Taburn/XInC2-Dev2/Releases/XInC2 Dev - v2.0.0 20210410/Render/XInC2 Dev v2.0 - 09 Top Ortho White.png

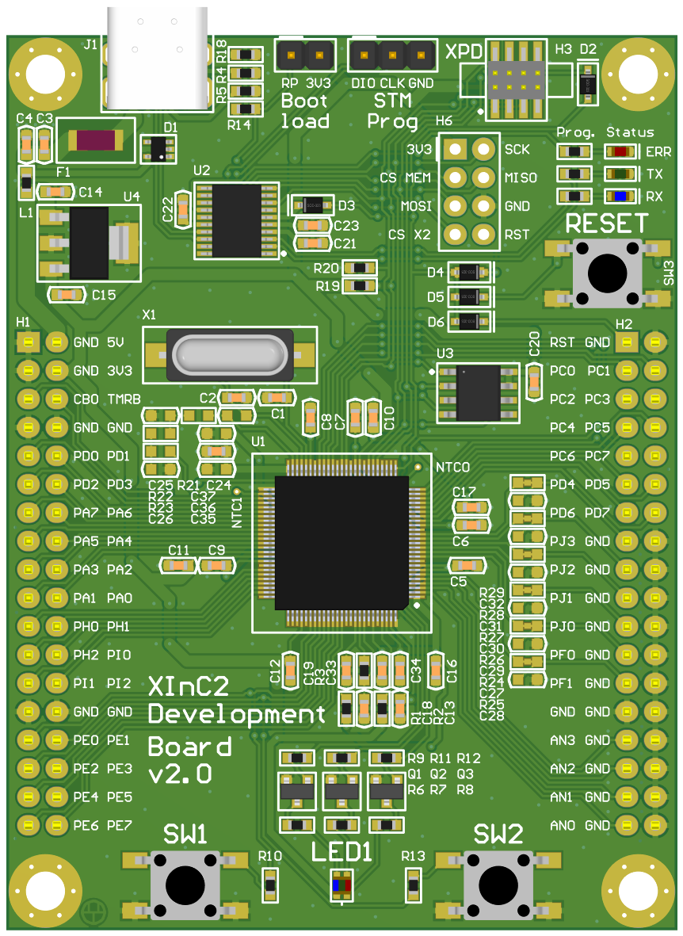
Releases/XInC2 Dev - v2.0.0 20210410/Render/XInC2 Dev v2.0 - 09 Top Ortho White.png
