Taburn/XInC2-Dev2/Fuse/I2t analysis.odt

One of the parameters for a fuse is I²t, which is a measure of the power the fuse can absorb before it melts and breaks the circuit.

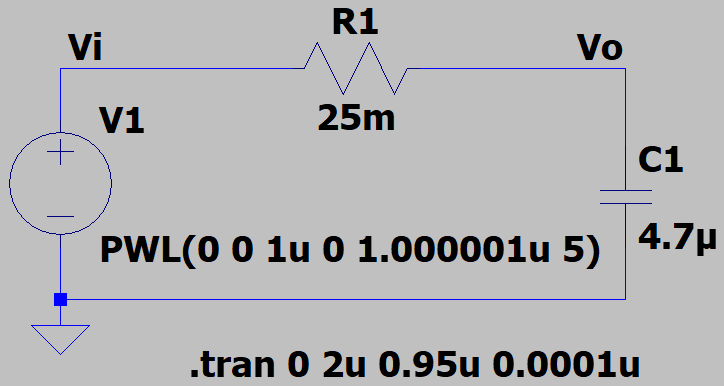
[picture p5: figure]

From basic circuit courses[^1] we know that, if V1 is suddenly turned on, the voltage across the capacitor will be:

V_o = V_{i} (1-e^(-t/RC))

Therefore, the current through the resistor will be:

I_R = {V_i - V_o} over {R}

I_R = {V_i - V_{i} (1-e^(-t/RC) )} over {R}

I_R = {V_i} over {R} ({1 - (1-e^(-t/RC) )})

I_R = {V_i} over {R} ({1 - 1+e^(-t/RC) })

underline {I_R = {V_i} over {R} e^(-t/RC)}

If the resistor is a fuse, we can find an expression for it’s I²t value:

I^2 t = int from{0} to{∞} I_R^2 dt

int from{0} to{∞} ({{V_i} over {R} e^(-t/RC)})^2 dt

( {V_i} over {R} )^2 int from{0} to{∞} e^(-2t/RC) dt

( {V_i} over {R} )^2 {RC} over {2}

underline { I2T = {V_i^2 C} over {2R}}

So, for a theoretical case where Vi = 5V, C = 4.7uF and R = 25mΩ: I²t = 2.35E-3

Let’s validate this by running the above simulation in LTspice:

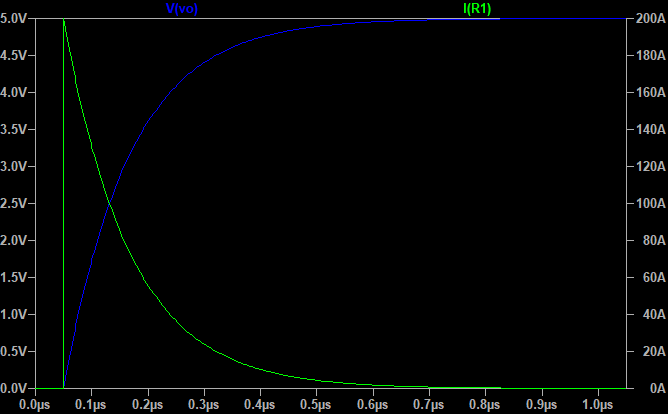
[picture p6: figure]

The csv data for I(R1) was exported. It’s value was squared, then imported into Graph:

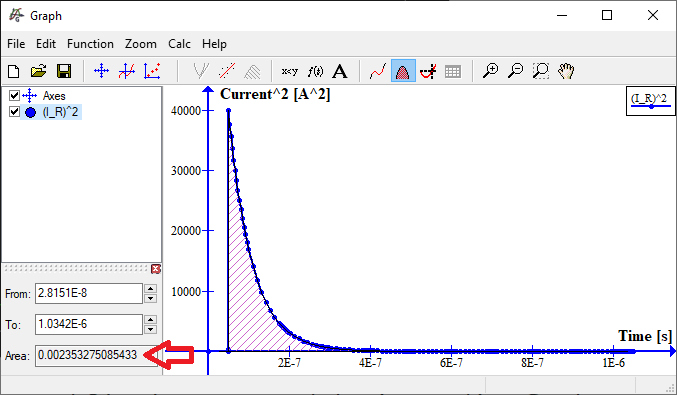
[picture p7: figure]

Graph calculated the integral as 2.3533E-3, which agrees with the theoretical value.

[^1] spinningnumbers.org/a/rc-step-response.html
