Taburn/XInC2-Dev2/Perf Spec/XInC2 Dev 2 Perf Spec Public 20210115.pdf

## XInC2 Dev 2 Perf Spec

Adam Gulyas
January 15, 2021

- The target audiences are university capstone groups and hobbyists.
- Design choices will heavily weight compatibility with Arduino and Raspberry Pi ecosystems.
- If possible, PCB design will be two layer, single sided.
- PCB will be able to populate either EEPROM or Flash memory ICs through the use of common footprints and pin outs. Compatible part numbers for each type will be identified.

XInC2 Dev 2
General Info
2021-01-07

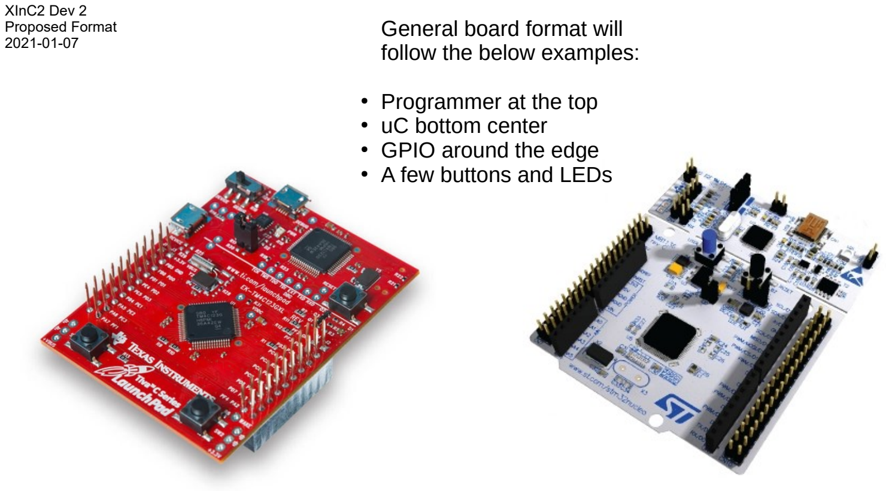
[picture p8: page 3]

Proposed Format
2021-01-07

General board format will
follow the below examples:
- Programmer at the top ● uC bottom center ● GPIO around the edge ● A few buttons and LEDs

Block Diagram
Rough PCB Layout
2021-01-07

No crystal pulling. Let
the user use TMRB for
something else.

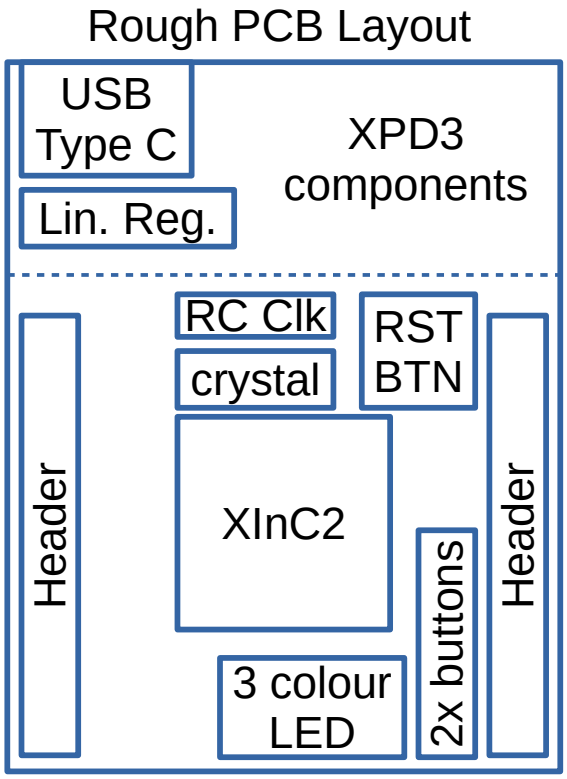
[picture p9: figure]
XPD3 components; XInC2; USB Type C; crystal; Lin. Reg.; 3 colour LED; RST BTN; RC Clk; er Rough PCB Layout
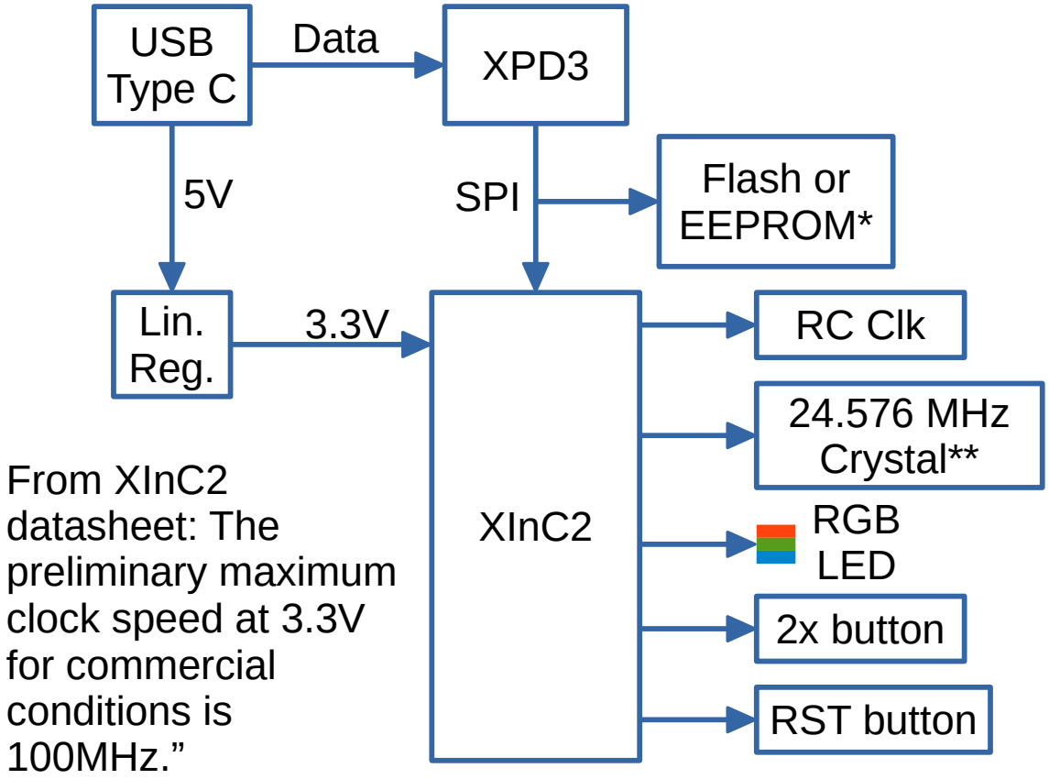
[picture p10: figure]
USB Type C; Lin. Reg.; XInC2; XPD3; RGB LED; SPI; 2x button; RST button; Data; 24.576 MHz Crystal**; RC Clk; From XInC2 datasheet: The preliminary maximum clock speed at 3.3V for commercial conditions is 100MHz.”; Flash or EEPROM*

* Either population option possible ** Use a common crystal footprint to enable using other frequencies
