Taburn/XInC2-Dev2/Releases/XInC2 Dev - v2.0.0 20210410/Placement/XInC2 Dev - Placement v2.0 20210410.pdf

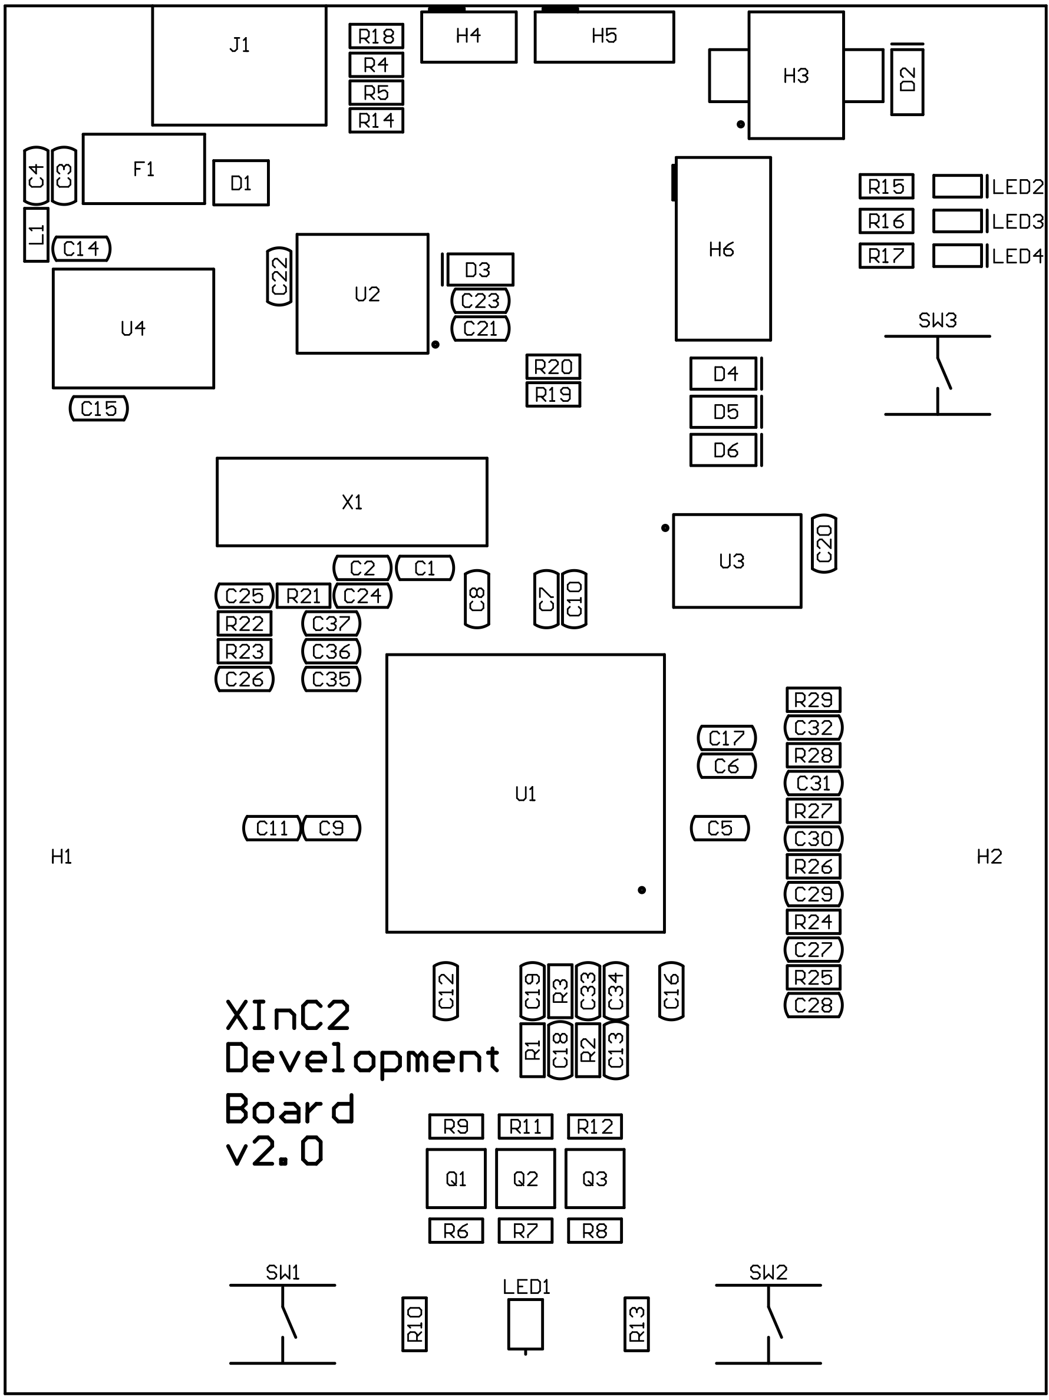
[picture p11: page 1]
