Taburn/XInC2-Dev2/Reference/Bolt Hole Footprint Dimensions.png

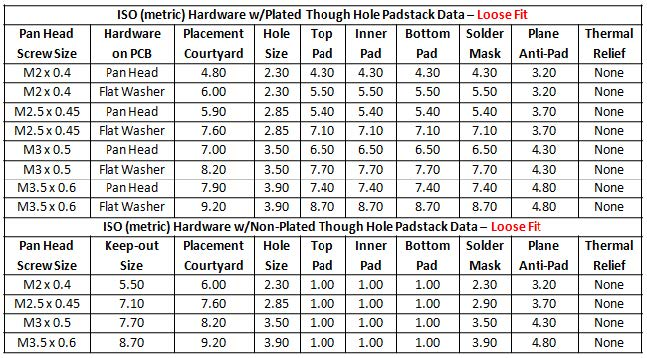
Reference/Bolt Hole Footprint Dimensions.png
