Taburn/XInC2-Dev2/Reference/USB Type C to Type A connection.png

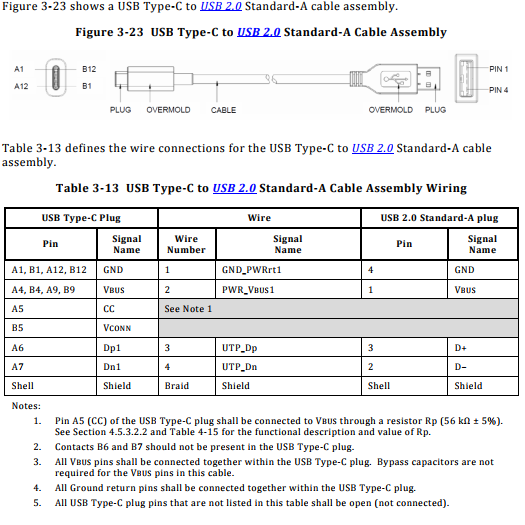
Reference/USB Type C to Type A connection.png
