Taburn/XInC2-Dev2/Releases/LED Board - v1.0.0 20210410/Placement/LED Board - Placement v1.0 20210410.png

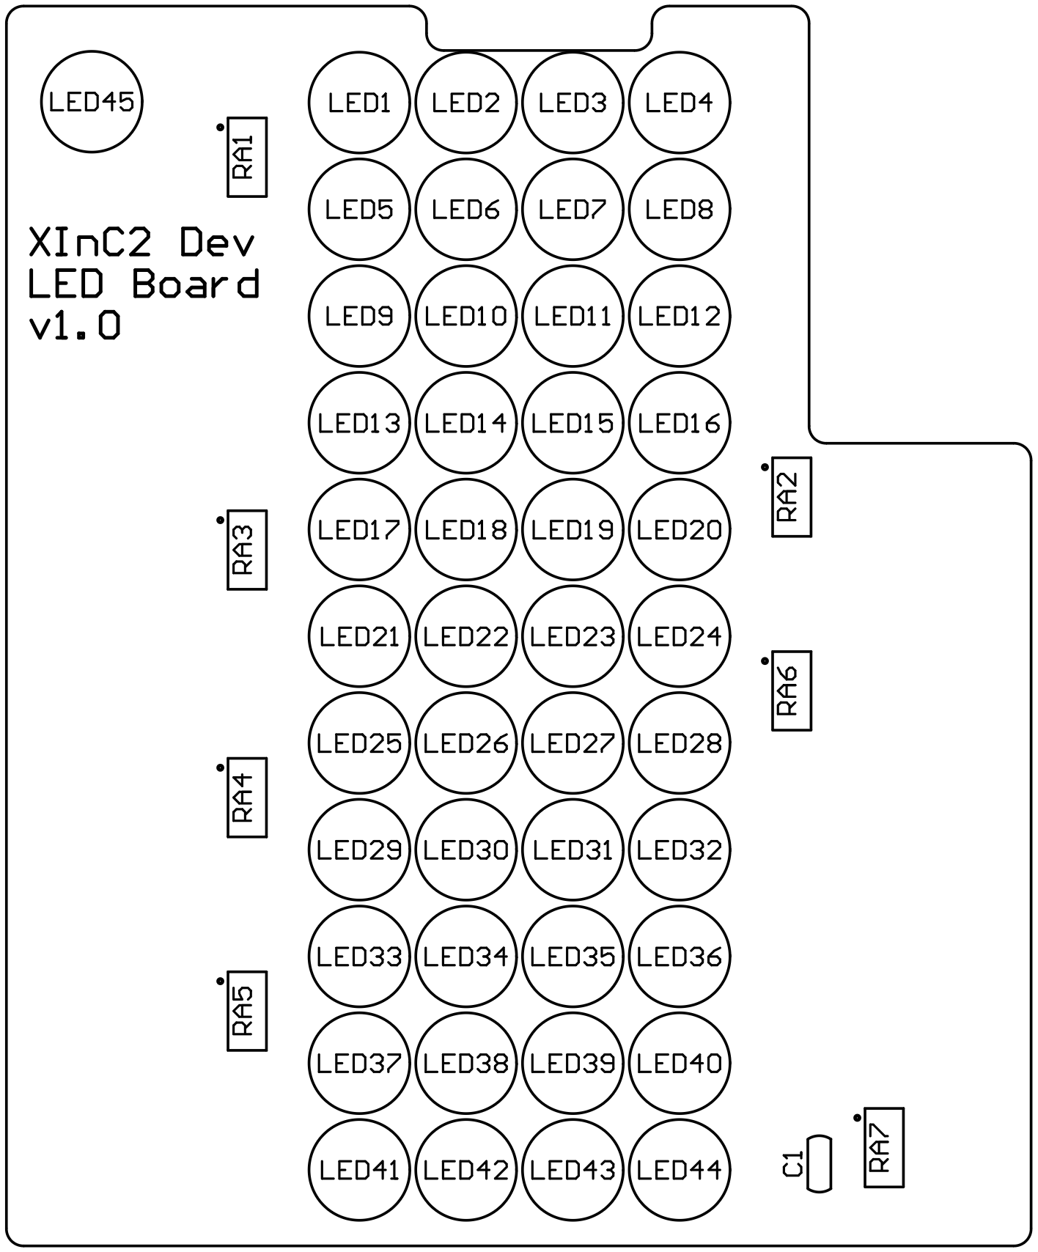
Releases/LED Board - v1.0.0 20210410/Placement/LED Board - Placement v1.0 20210410.png
