Taburn/XInC2-Dev2/Releases/LED Board - v1.0.0 20210410/Render/LED Board - 3 Top ISO.png

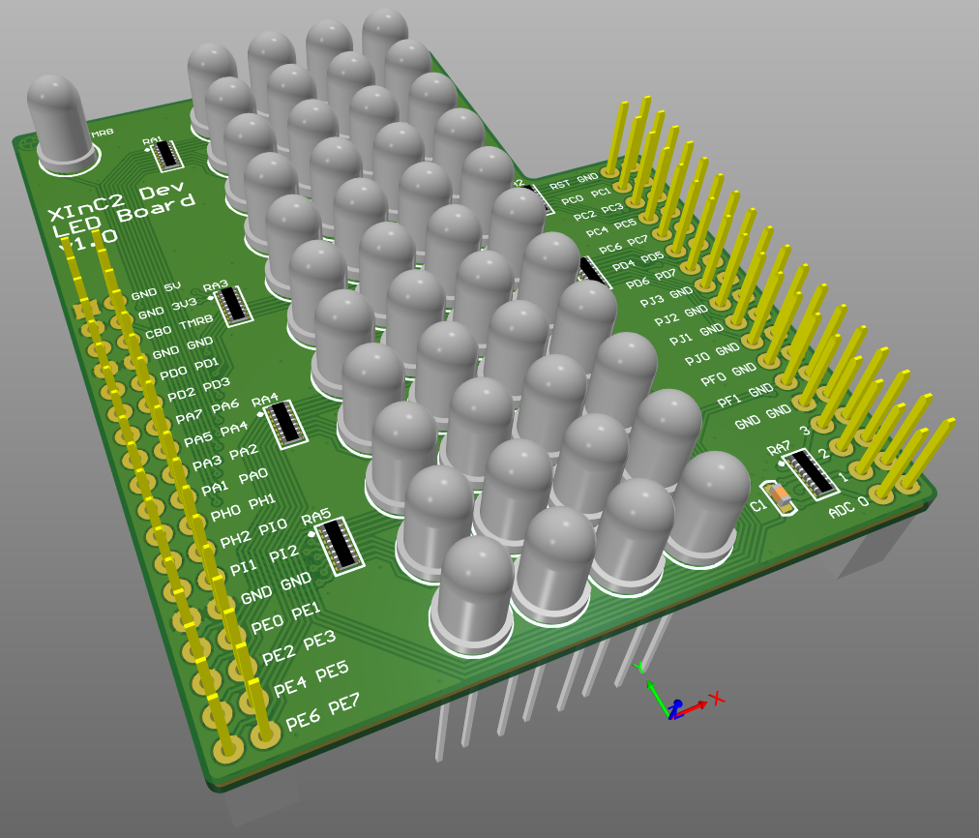
Releases/LED Board - v1.0.0 20210410/Render/LED Board - 3 Top ISO.png
