Taburn/XInC2-Dev2/Releases/LED Board - v1.0.0 20210410/Render/LED Board - 4 Top Layer.png

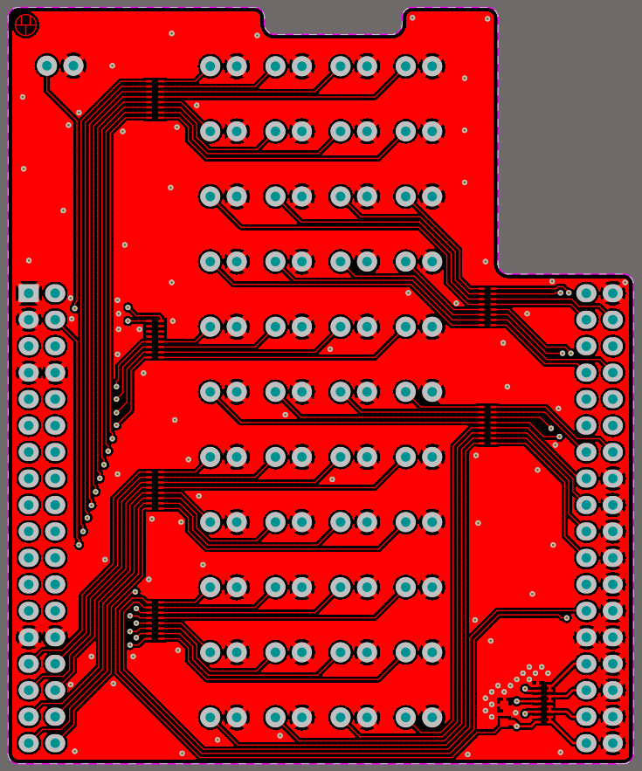
Releases/LED Board - v1.0.0 20210410/Render/LED Board - 4 Top Layer.png
