Taburn/XInC2-Dev2/LED Shield/LED Shield - STEP.step

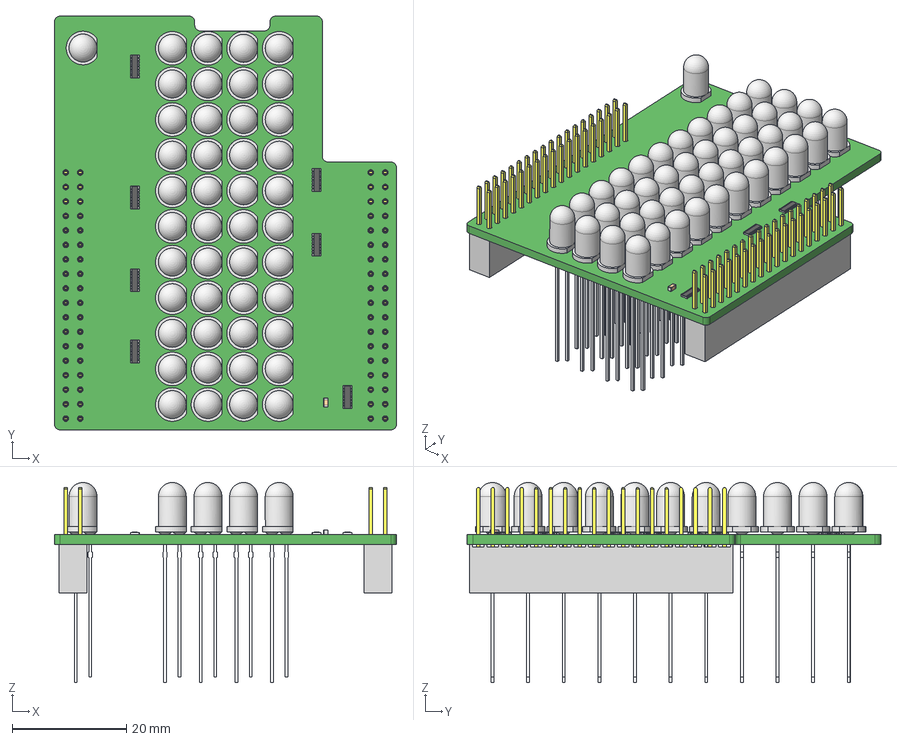
[picture p30: CAD file, 2021-04-11]
LED Shield/LED Shield - STEP.step
60.0 x 72.6 x 35.1 mm
Board
ceramic_cap_0603
_T1SSQ-118-03-T-D x 2
_P2SSQ-118-03-T-D x 2
YC248 x 7
Wurth_-_151051BS04000_-_TH_LED x 45
