Taburn/XInC2-Dev2/Releases/XInC2 Dev - v2.0.0 20210410/Mechanical/XInC2 Dev - Holes v2.0 20210410.dxf

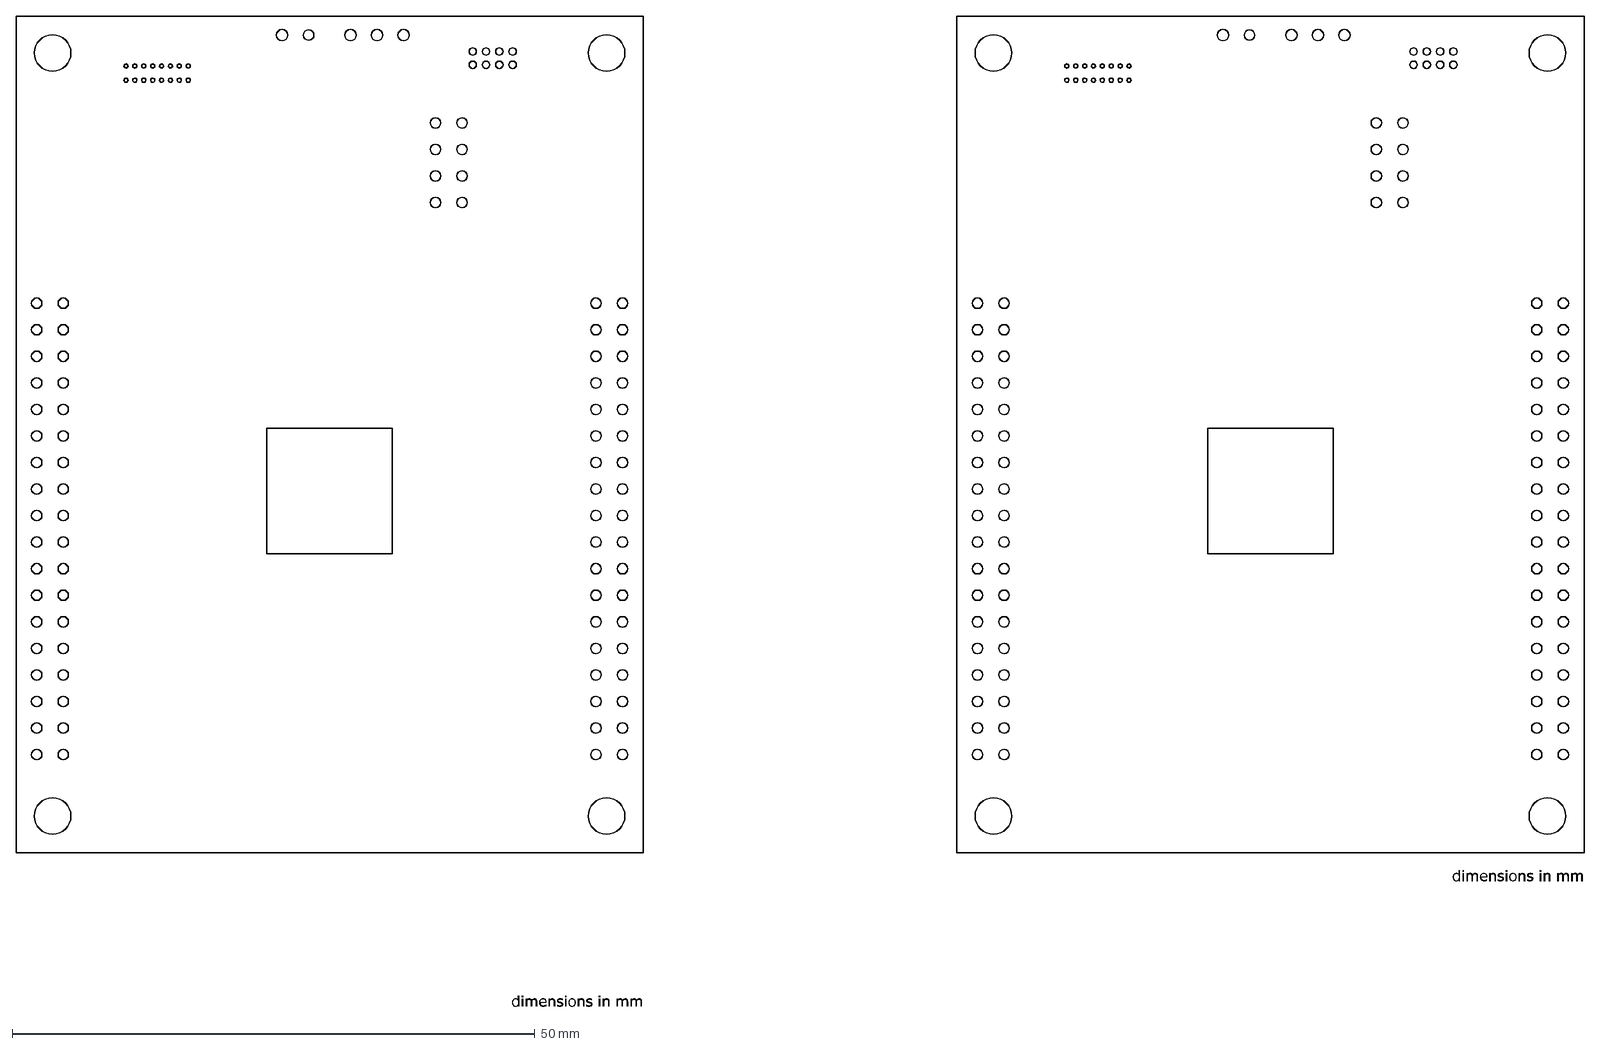
[picture p31: CAD file, 2021-04-11]
Releases/XInC2 Dev - v2.0.0 20210410/Mechanical/XInC2 Dev - Holes v2.0 20210410.dxf
dimensions in mm
