Taburn/XInC2-Dev2/Step Files/USB4085-GF-A.stp

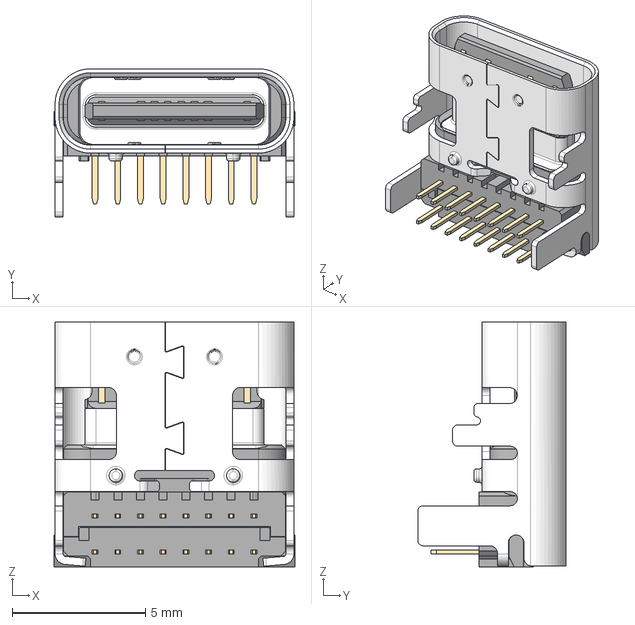
[picture p32: CAD file, 2021-04-11]
Step Files/USB4085-GF-A.stp
9.03 x 5.56 x 9.17 mm
ÇÐ³ý-ÀÉì1
Í¹Ì¨-ÀÉì1
