Taburn/XInC2-Dev2/Step Files/SSQ-118-03-T-D.stp

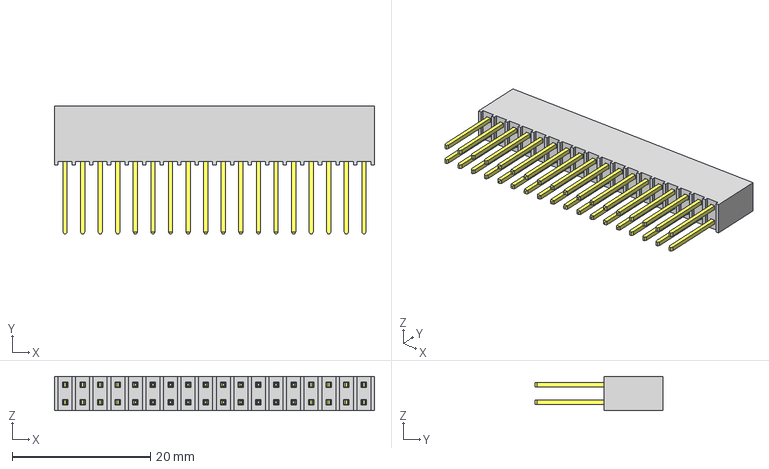
[picture p33: CAD file, 2021-04-11]
Step Files/SSQ-118-03-T-D.stp
46.2 x 18.5 x 4.95 mm
_T1SSQ-118-03-T-D
_P2SSQ-118-03-T-D
