Taburn/XInC2-Dev2/Step Files/SOIC 8.step

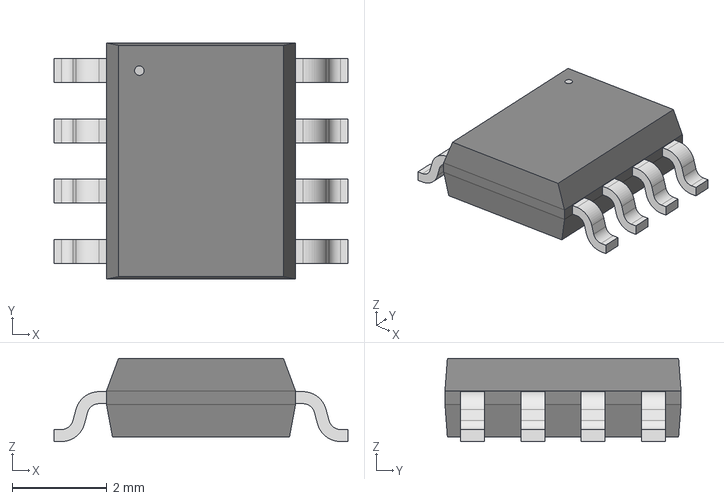
[picture p34: CAD file, 2021-02-04]
Step Files/SOIC 8.step
6.20 x 4.98 x 1.75 mm
