Taburn/XInC2-Dev2/Step Files/TQFP100 0_4mm.step

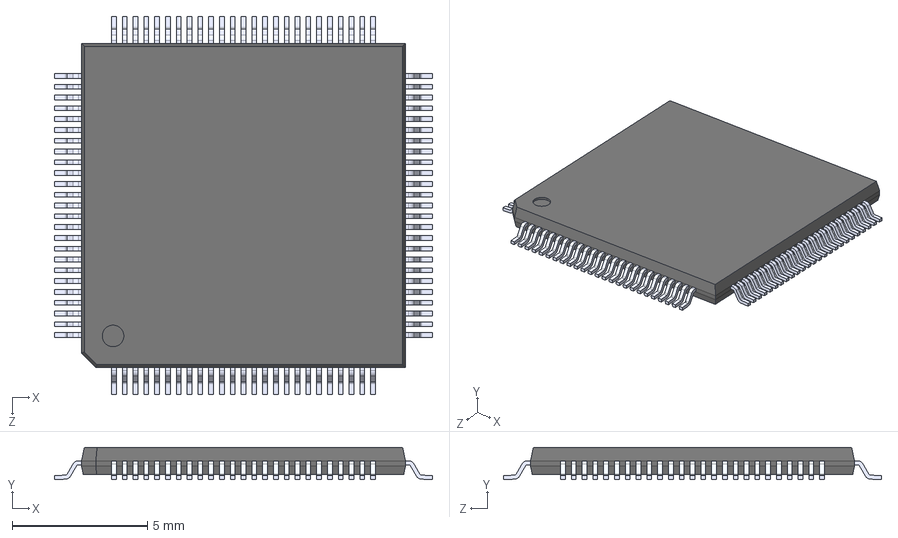
[picture p35: CAD file, 2021-02-04]
Step Files/TQFP100 0_4mm.step
14.0 x 1.20 x 14.0 mm
