Taburn/XInC2-Dev2/Step Files/FFSD-04-S-01.00-01.stp

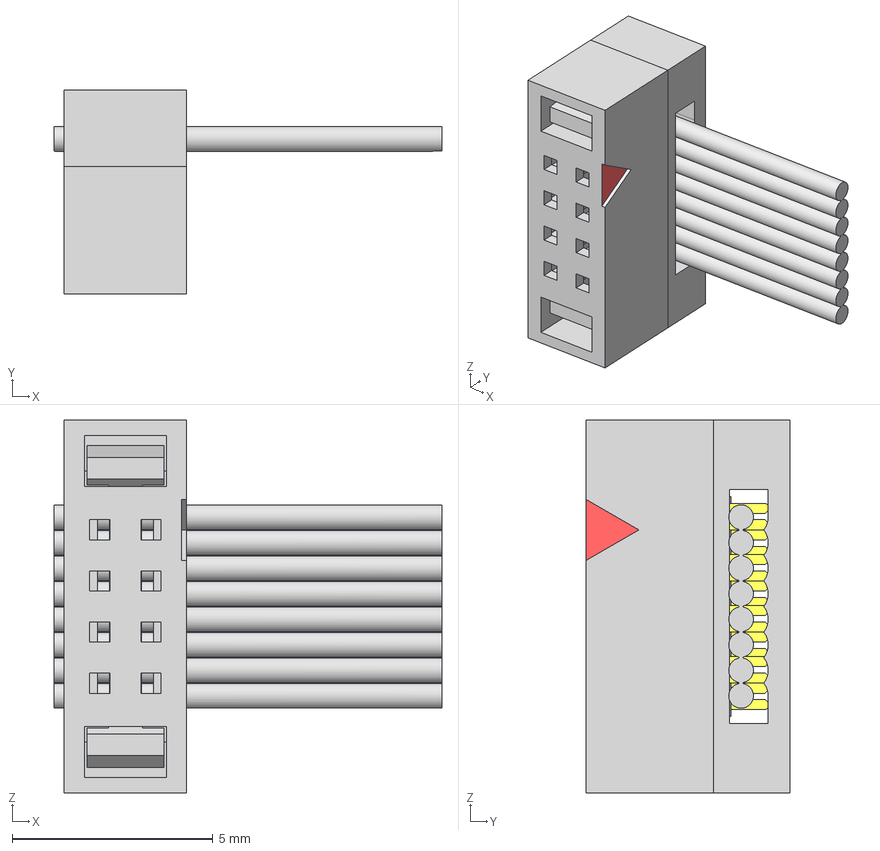
[picture p36: CAD file, 2021-02-04]
Step Files/FFSD-04-S-01.00-01.stp
9.65 x 5.08 x 9.27 mm
_FFSD-040LB
_FFSD-04()ub
_FFSD-04pin x 2
