Taburn/XInC2-Dev2/Step Files/FTS-104-01-L-DV.stp

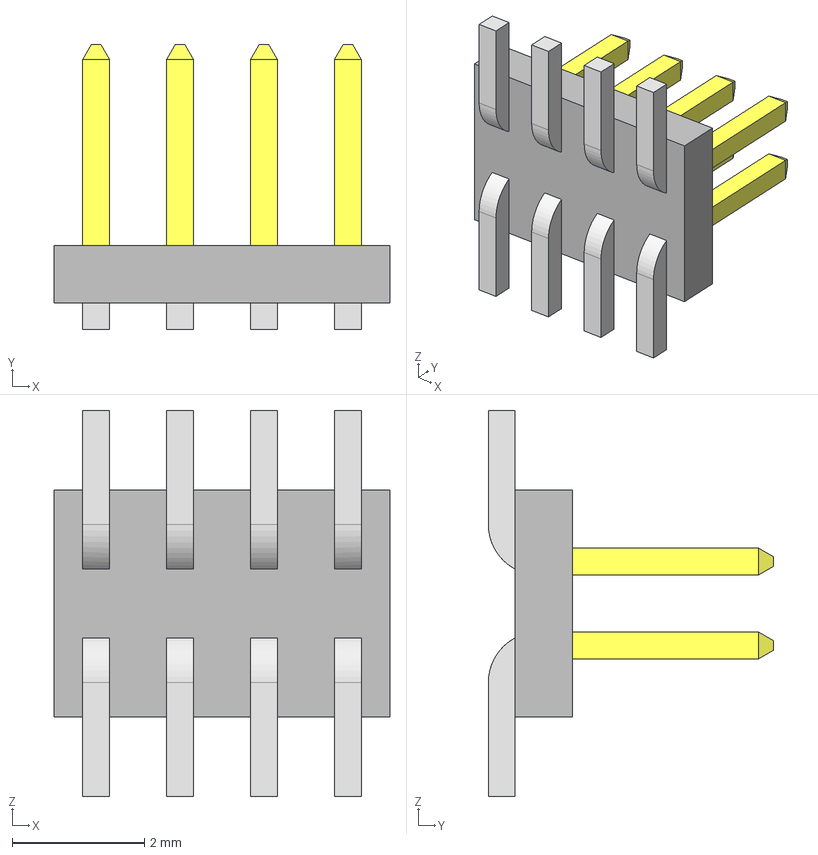
[picture p37: CAD file, 2021-02-04]
Step Files/FTS-104-01-L-DV.stp
5.08 x 4.32 x 5.84 mm
_FTS-104-01-L-DV_body
_FTS-104-01-L-DV_pins1
_FTS-104-01-L-DV_pins2
