Taburn/XInC2-Dev2/Step Files/YC248.step

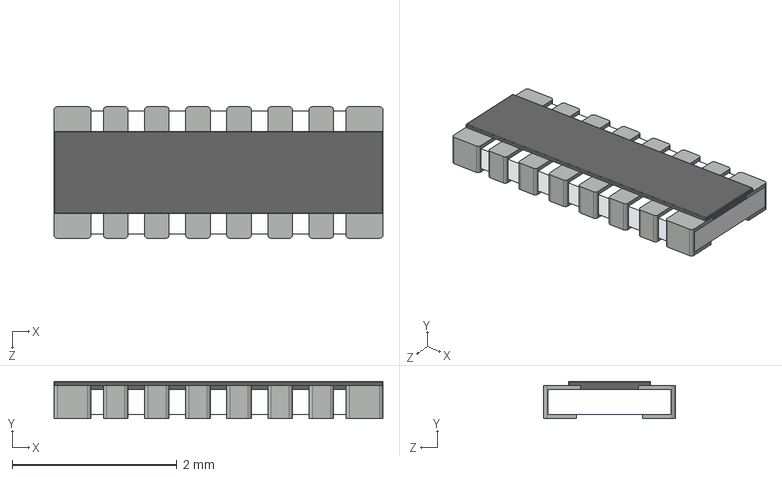
[picture p38: CAD file, 2021-01-30]
Step Files/YC248.step
4.00 x 0.45 x 1.60 mm
