Taburn/XInC2-Dev2/Step Files/Wurth - 151051BS04000 - TH LED.stp

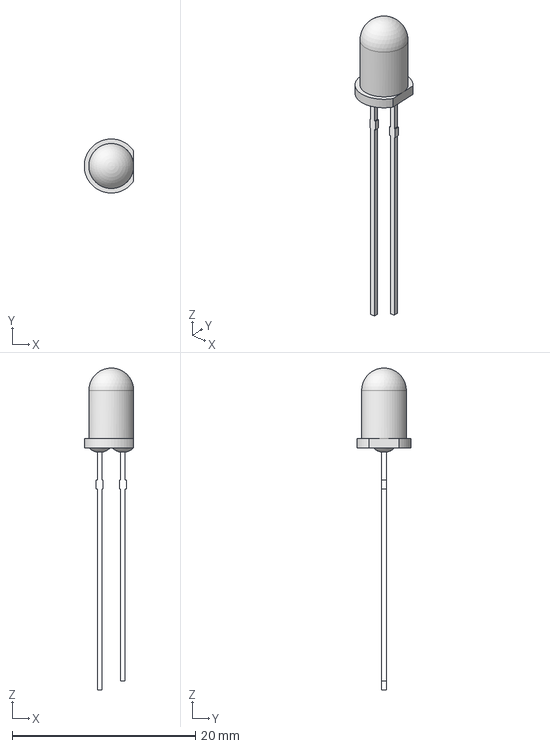
[picture p39: CAD file, 2021-01-30]
Step Files/Wurth - 151051BS04000 - TH LED.stp
5.39 x 5.90 x 35.1 mm
