Taburn/XInC2-Dev2/Step Files/SOT 223.step

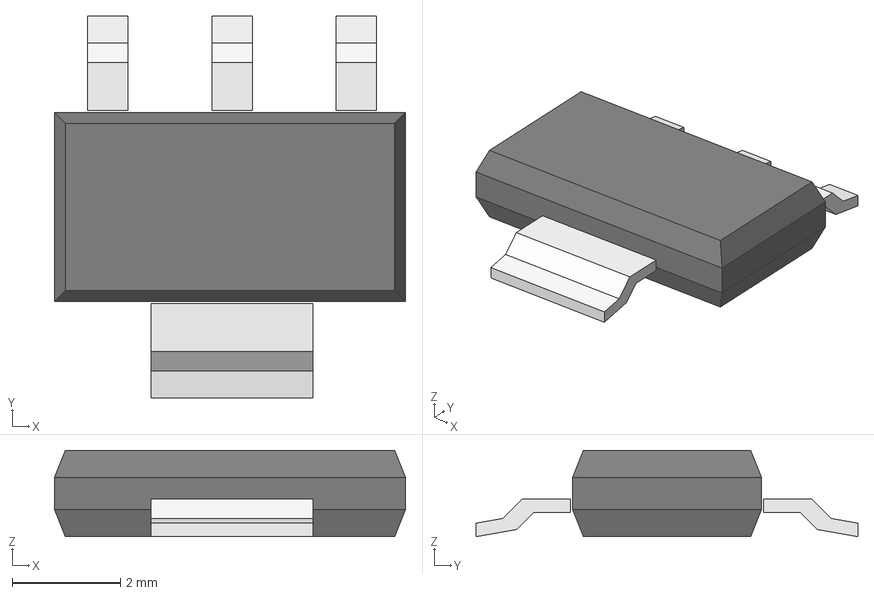
[picture p40: CAD file, 2021-01-26]
Step Files/SOT 223.step
6.50 x 7.07 x 1.60 mm
