Taburn/XInC2-Dev2/Step Files/SW - tact - SMT - HP0315AFKP2.stp

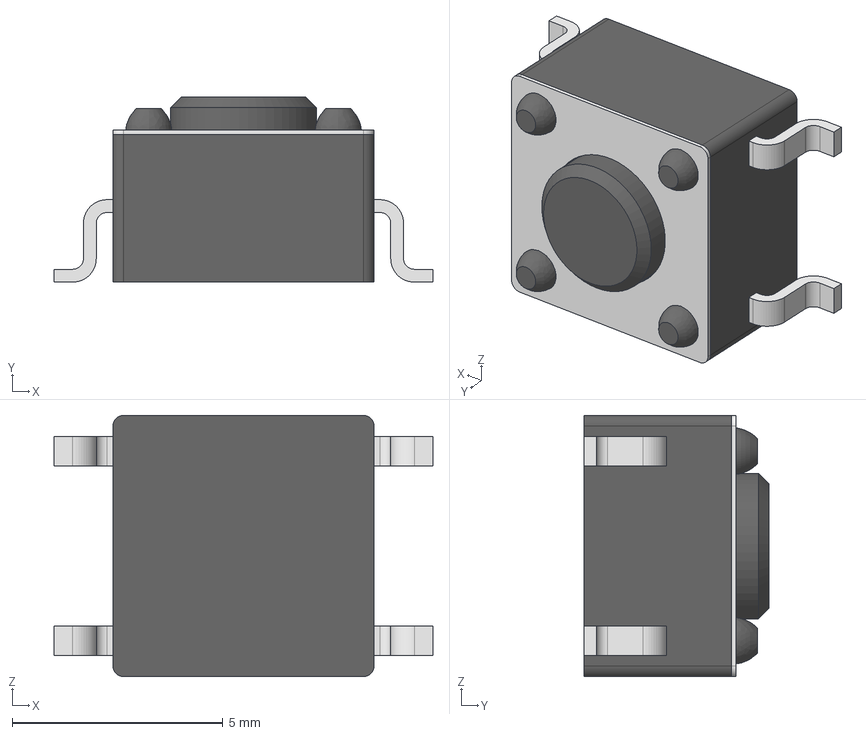
[picture p41: CAD file, 2021-01-26]
Step Files/SW - tact - SMT - HP0315AFKP2.stp
8.99 x 4.39 x 6.20 mm
_hp03-body
_hp03-cap
_hp03-button
_hp03-pinn-P2 x 4
