Taburn/XInC2-Dev2/Step Files/TSSOP 20.stp

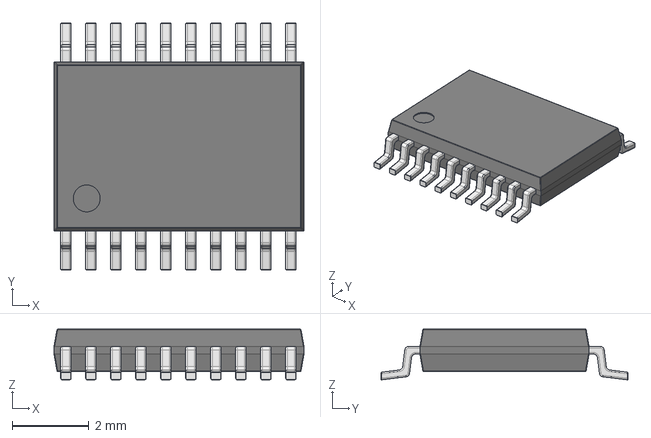
[picture p42: CAD file, 2021-01-26]
Step Files/TSSOP 20.stp
6.50 x 6.42 x 1.32 mm
扻豵鵨 TSSOP-20
Êîíòàêò x 20
