Taburn/XInC2-Dev2/Step Files/SOD 323.STEP

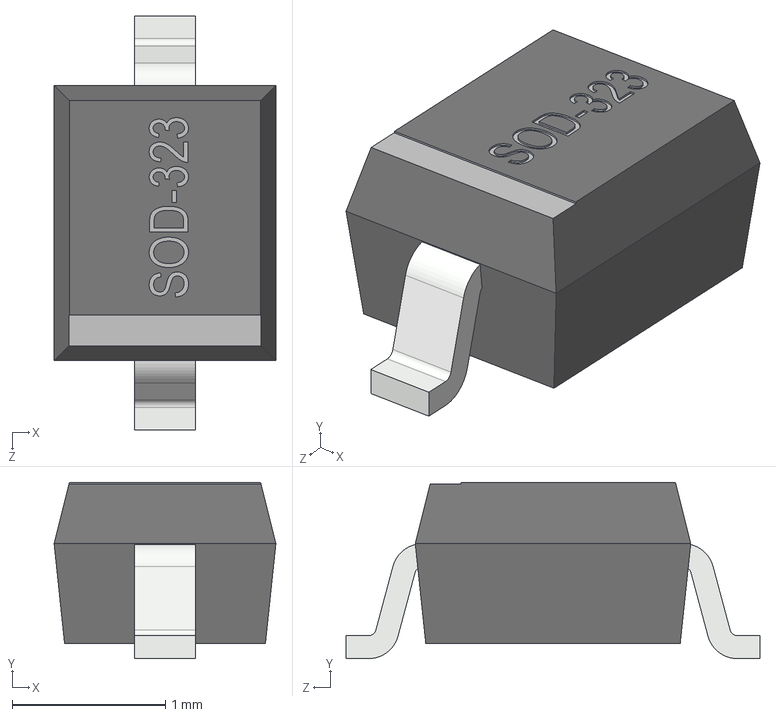
[picture p43: CAD file, 2021-01-26]
Step Files/SOD 323.STEP
1.45 x 1.15 x 2.70 mm
