Taburn/XInC2-Dev2/Step Files/USB4110-GF-A.stp

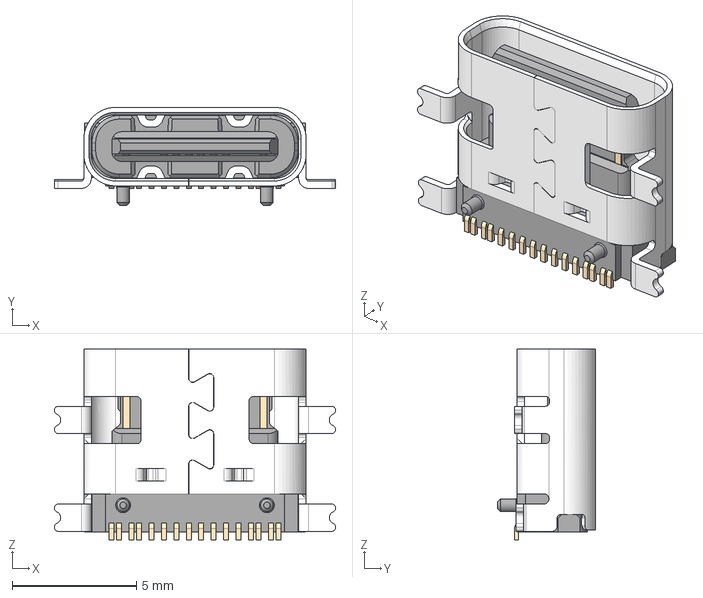
[picture p44: CAD file, 2021-01-26]
Step Files/USB4110-GF-A.stp
11.3 x 3.96 x 7.68 mm
