Taburn/XInC2-Dev2/Step Files/HC49 US.STEP

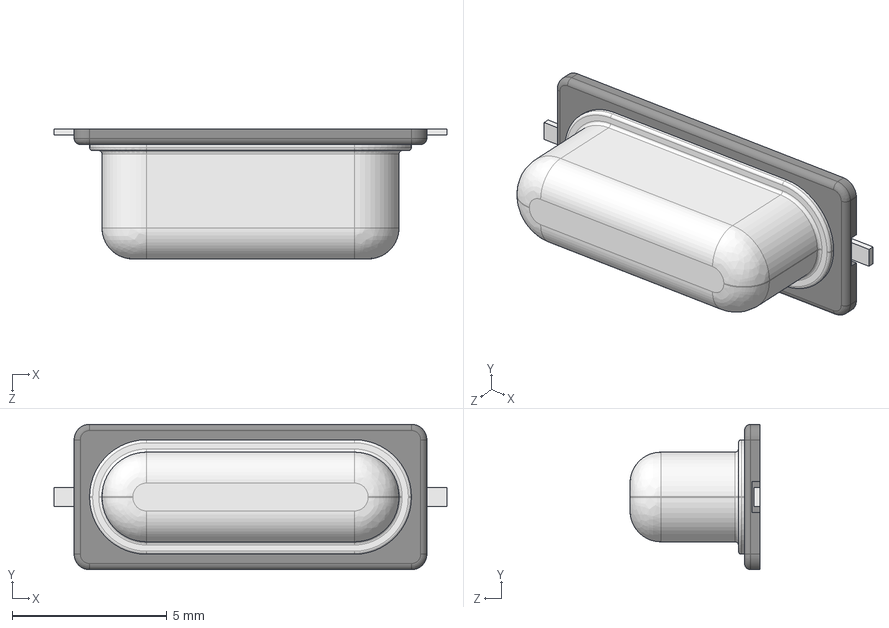
[picture p45: CAD file, 2021-01-26]
Step Files/HC49 US.STEP
12.7 x 4.70 x 4.20 mm
