Taburn/XInC2-Dev2/Step Files/C 0603.stp

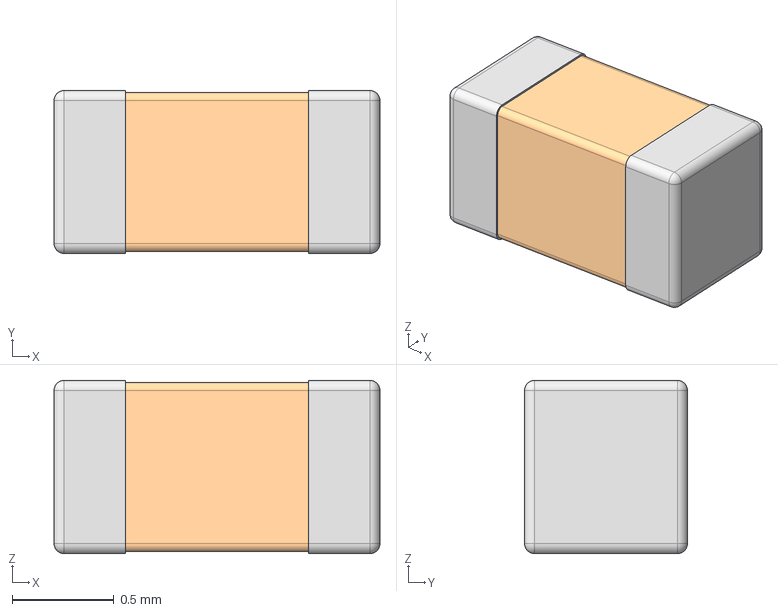
[picture p46: CAD file, 2021-01-26]
Step Files/C 0603.stp
1.60 x 0.8 x 0.85 mm
