Taburn/XInC2-Dev2/Step Files/SOT 353.STEP

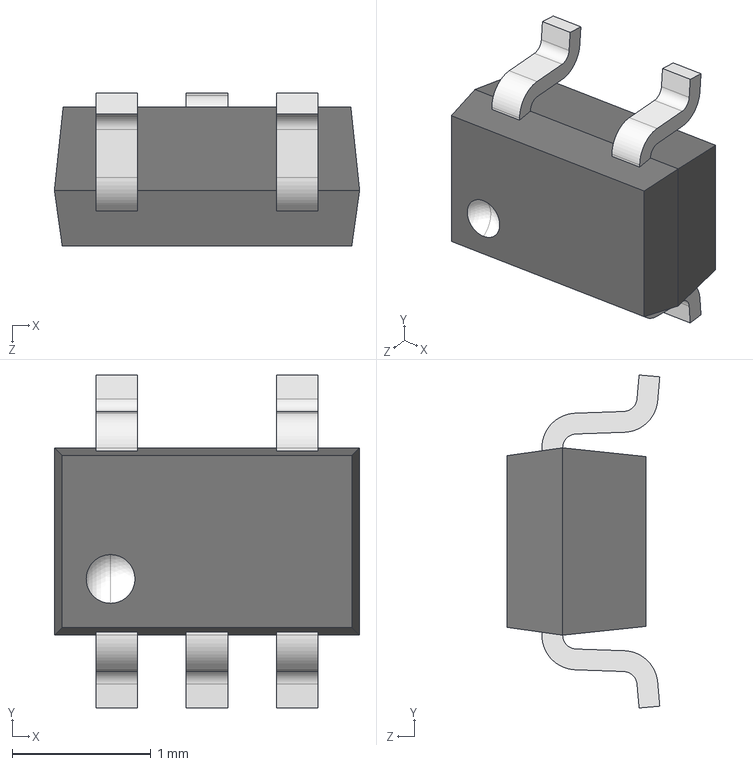
[picture p47: CAD file, 2021-01-26]
Step Files/SOT 353.STEP
2.20 x 2.40 x 1.10 mm
