Taburn/XInC2-Dev2/Step Files/SSW-116-03-G-D.stp

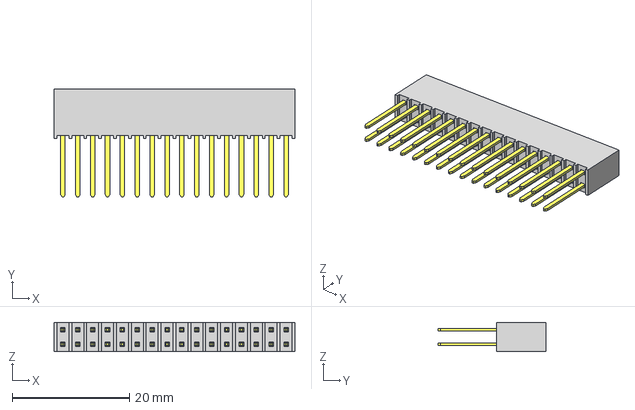
[picture p48: CAD file, 2021-01-24]
Step Files/SSW-116-03-G-D.stp
41.1 x 18.5 x 4.95 mm
_T1SSW-116-03-G-D
_P2SSW-116-03-G-D
