Taburn/XInC2-Dev2/Step Files/LED SMT Dual.stp

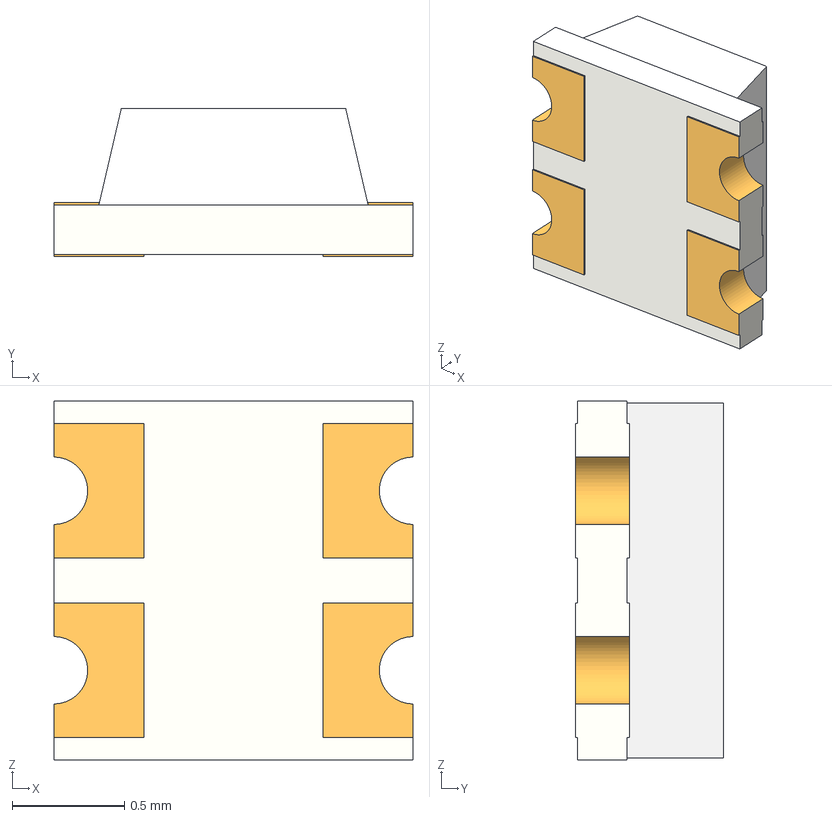
[picture p49: CAD file, 2021-01-24]
Step Files/LED SMT Dual.stp
1.60 x 0.66 x 1.60 mm
