Taburn/XInC2-Dev2/Step Files/R 0603.step

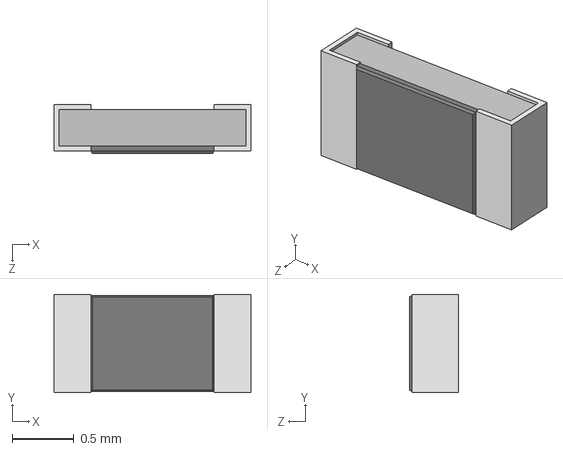
[picture p50: CAD file, 2021-01-24]
Step Files/R 0603.step
1.60 x 0.8 x 0.4 mm
