Taburn/XInC2-Dev2/Step Files/SSQ-116-03-T-D.stp

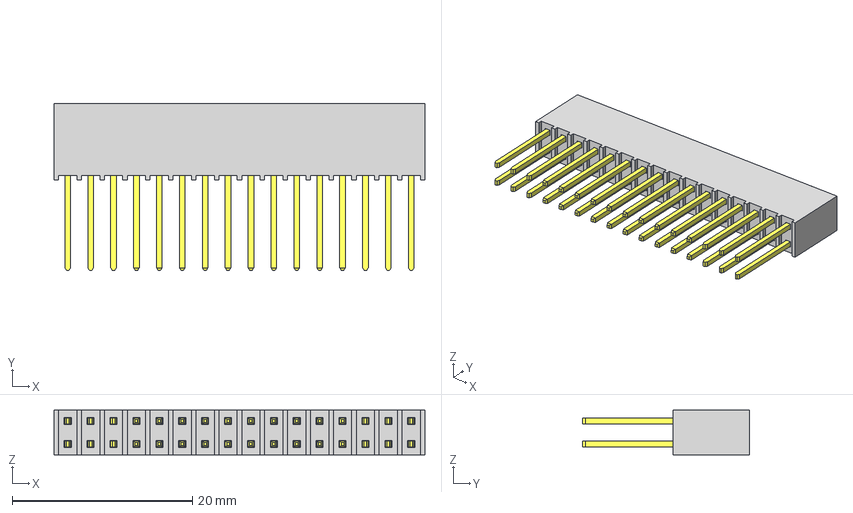
[picture p51: CAD file, 2021-01-24]
Step Files/SSQ-116-03-T-D.stp
41.1 x 18.5 x 4.95 mm
_T1SSQ-116-03-T-D
_P2SSQ-116-03-T-D
