Taburn/XInC2-Dev2/Step Files/SOT 23-3.step

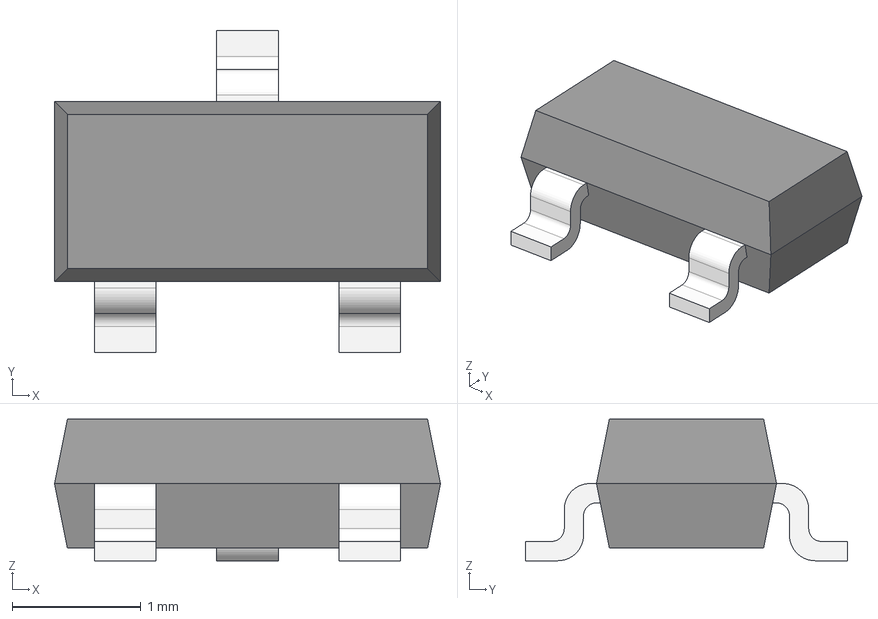
[picture p52: CAD file, 2021-01-24]
Step Files/SOT 23-3.step
3.00 x 2.50 x 1.10 mm
