Taburn/XInC2-Dev2/Step Files/SOD 123.step

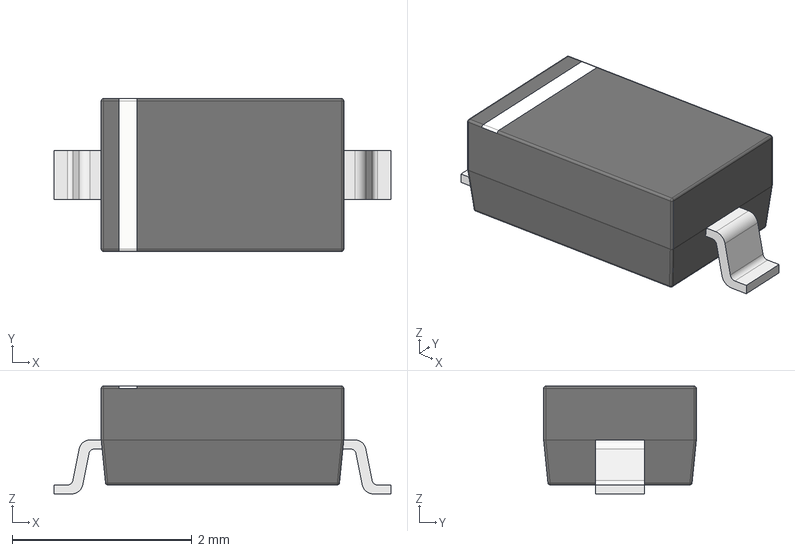
[picture p53: CAD file, 2021-01-24]
Step Files/SOD 123.step
3.75 x 1.70 x 1.20 mm
pin
pin(Mirror)
icbody
