Taburn/XInC2-Dev2/(list of files, cad)

Other CAD files:
Releases/LED Board - v1.0.0 20210410/LED Board - STEP v1.0 20210410.step
Step Files/M3 10mm Machine Screw 92000A120.step
