Taburn/XInC2-Dev2/Releases/LED Board - v1.0.0 20210410/LED Board - SCH v1.0.0 20210410.pdf

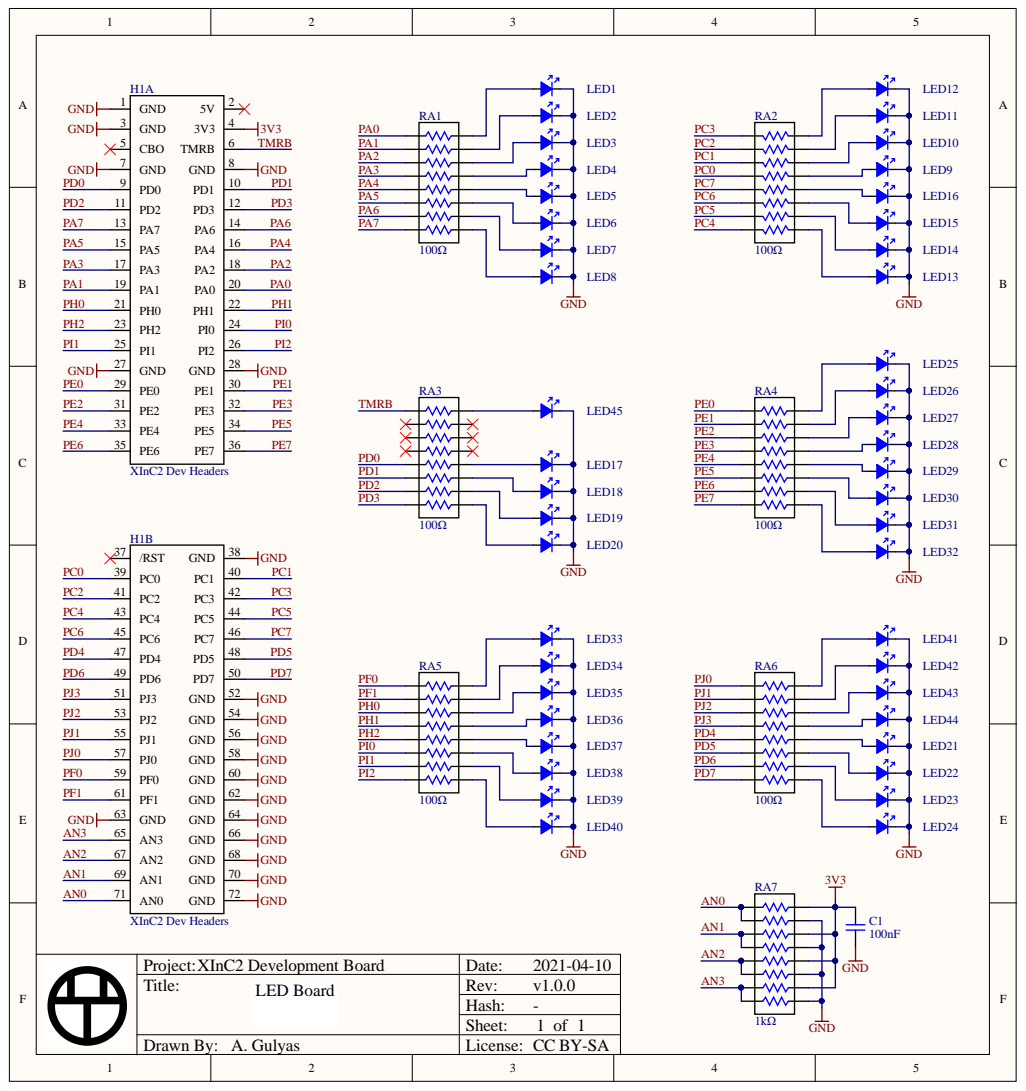
[picture p54: page 1]

Project:XInC2 Develo pment Board | Date: 2 0 2 1-0 4-1 0

Rev : v 1.0.0
