Taburn/XInC2-Dev2/Releases/XInC2 Dev - v2.0.0 20210410/Mechanical/XInC2 Dev - Holes v2.0 20210410.pdf

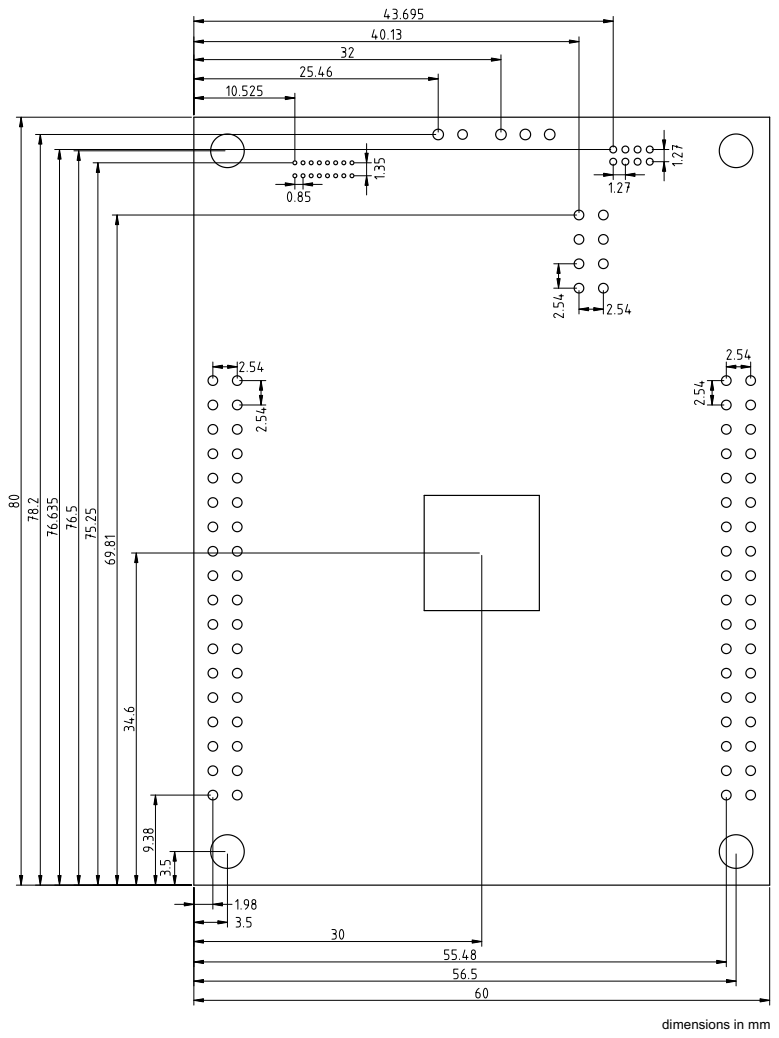
[picture p55: page 1]

dimensions in mm

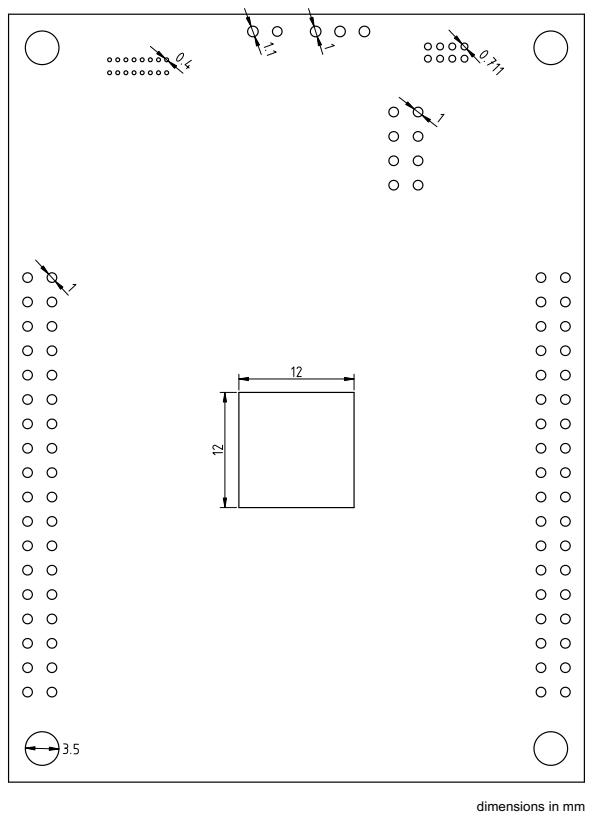
[picture p56: page 2]

dimensions in mm
