Taburn/XInC2-Dev2/Releases/XInC2 Dev - v2.0.0 20210410/XInC2 Dev - SCH v2.0.0 20210410.pdf

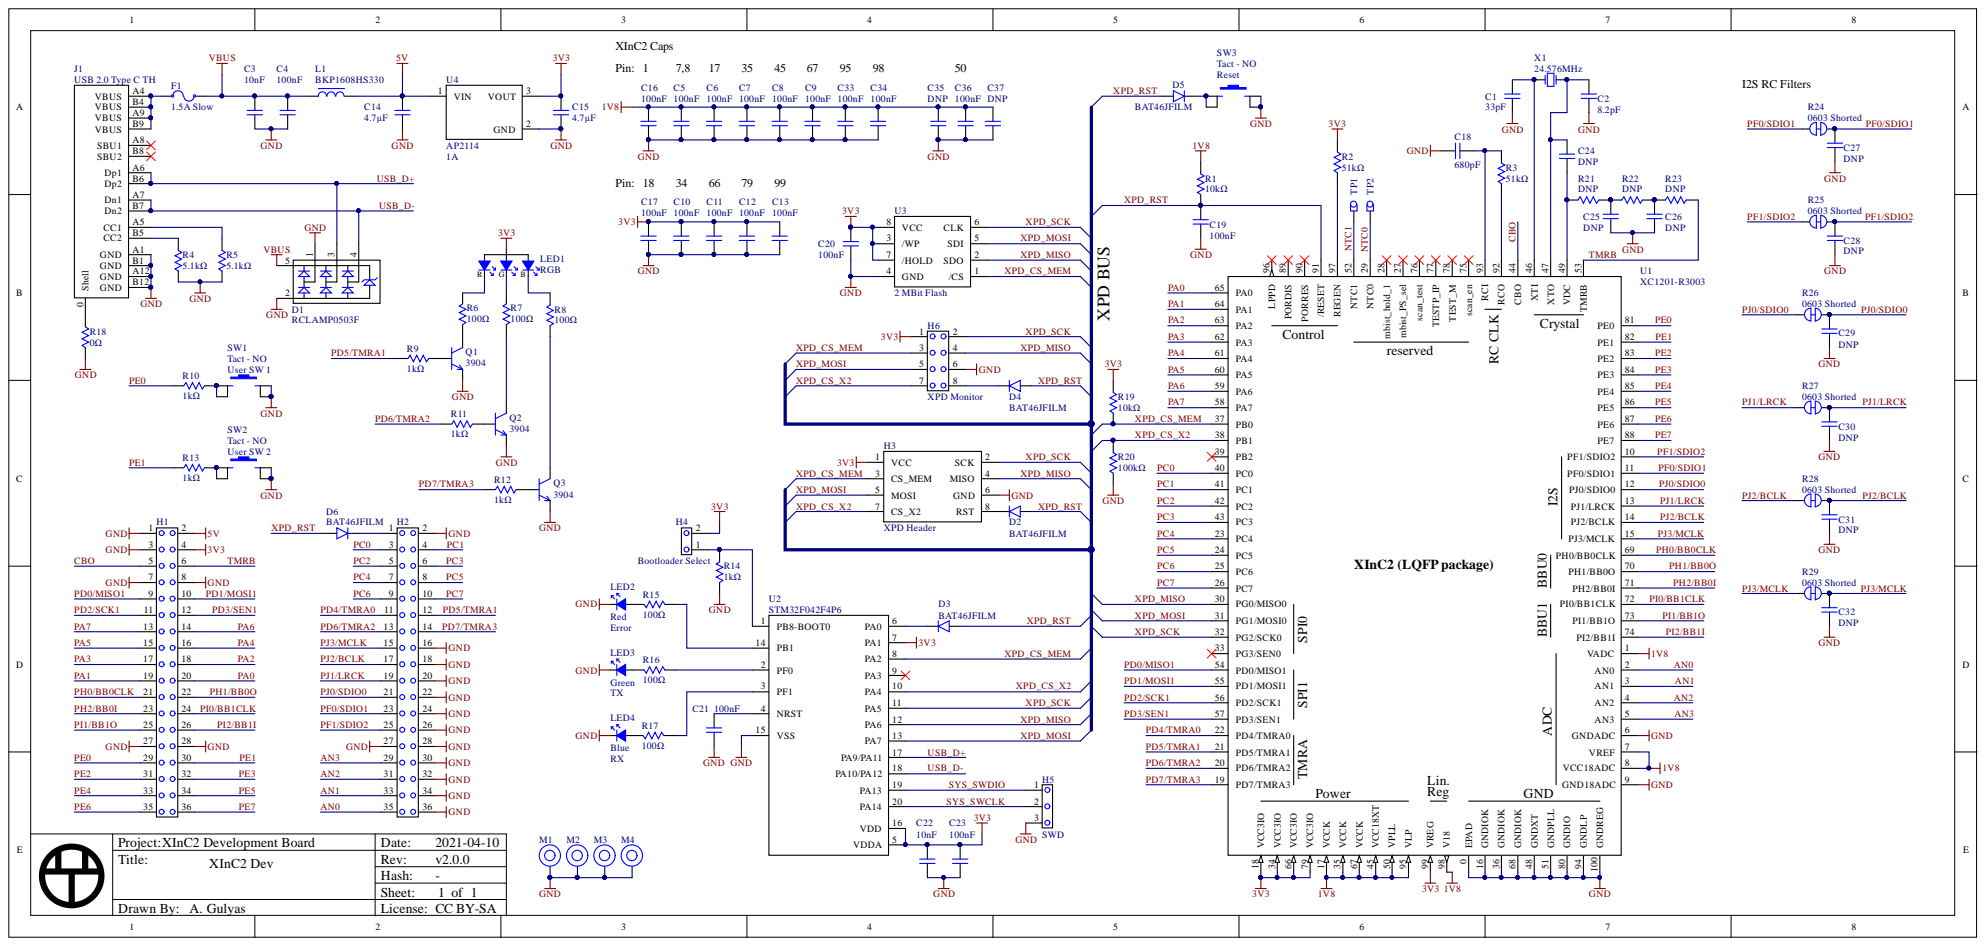
[picture p57: page 1]
