Taburn/XInC2-Dev2/Fuse/Spice/Inrush Current.asc

C1: cap; 4.7µ
R1: res; 25m
V1: voltage; PWL(0 0 1u 0 1.000001u 5)
Named nets: 0, Vi, Vo
.tran 0 2u 0.95u 0.0001u
