Taburn/XInC2-Dev2/(list of files, drawings)

Other design files:
Altium/Public Library.PcbLib
Altium/Public Library.SchLib
Altium/XInC2 Dev - SCH.SchDoc
Altium/XInC2 Dev.PrjPCB
LED Shield/LED Shield - PCB.PcbDoc
LED Shield/LED Shield - SCH.SchDoc
LED Shield/LED Shield.PrjPCB
Releases/LED Board - v1.0.0 20210410/Altium/LED Board - PCB v1.0 20210410.PcbDoc
Releases/LED Board - v1.0.0 20210410/Altium/LED Board - SCH v1.0.0 20210410.SchDoc
Releases/LED Board - v1.0.0 20210410/Placement/LED Board - Placement v1.0 20210410.PcbDoc
Releases/XInC2 Dev - v2.0.0 20210410/Altium/Public Library.PcbLib
Releases/XInC2 Dev - v2.0.0 20210410/Altium/Public Library.SchLib
Releases/XInC2 Dev - v2.0.0 20210410/Altium/XInC2 Dev - SCH v2.0.0 20210410.SchDoc
Releases/XInC2 Dev - v2.0.0 20210410/Altium/XInC2 Dev v2.0.0.PrjPCB
