Taburn/XInC2-Dev2/(commit log)

2021-01-23 add Altium files
    [Public Library.SchLib, XInC2 Dev - SCH.SchDoc, XInC2 Dev.PrjPCB]
2021-01-24 add data sheets and step files
    [LED SMT Dual.stp, R 0603.step, SOD 123.step, SOT 23-3.step, SSQ-116-03-T-D.stp, SSW-116-03-G-D.stp]
2021-01-24 add to schematic, add PcbLib
    [Public Library.PcbLib, Public Library.SchLib, XInC2 Dev - SCH.SchDoc, XInC2 Dev.PrjPCB]
2021-01-26 add step files and data sheets
    [C 0603.stp, HC49 US.STEP, SOD 323.STEP, SOT 223.step, SOT 353.STEP, SW - tact - SMT - HP0315AFKP2.stp, TSSOP 20.stp, USB4110-GF-A.stp]
2021-01-26 Schematic is ready to review. Need some info from Eleven to finish.
    [Public Library.PcbLib, Public Library.SchLib, XInC2 Dev - SCH.SchDoc]
2021-01-26 update PrjPCB
    [XInC2 Dev.PrjPCB]
2021-01-26 fix symbol pin numbers
    [Public Library.SchLib, XInC2 Dev - SCH.SchDoc]
2021-01-30 add data sheets, reference, step files
    [M3 10mm Machine Screw 92000A120.step, Wurth - 151051BS04000 - TH LED.stp, YC248.step]
2021-02-04 add changes to schematic suggested by Eleven
    [FFSD-04-S-01.00-01.stp, FTS-104-01-L-DV.stp, Public Library.PcbLib, Public Library.SchLib, SOIC 8.step, TQFP100 0_4mm.step, XInC2 Dev - SCH.SchDoc, XInC2 Dev.PrjPCB]
2021-02-04 Found a formula for calculating the I2t of a fuse. This might make a good journal write up.
    [Inrush Current.ods]
2021-04-11 Ready to go to copper on both the Dev board and the LED board.
    [LED Board - BOM v1.0.0 20210410.xlsx, LED Board - PCB v1.0 20210410.PcbDoc, LED Board - Placement v1.0 20210410.PcbDoc, LED Board - SCH v1.0.0 20210410.SchDoc, LED Board - STEP v1.0 20210410.step, LED Shield - PCB.PcbDoc, LED Shield - SCH.SchDoc, LED Shield - STEP.step]
