Taburn/XInC2-Dev2/(notices)

Notices in the files:
Step Files/USB4085-GF-A.stp:
FILE_NAME( 'p:/temp/worker_4/temp/exporttempdir_2208_266_j487b/format_0/USB4085-GF-A.stp', '2021-02-21T00:15:45', ( 'License CC BY-ND 4.0' ), ( 'CADENAS' ), ' ', 'PARTsolutions', ' ' );
Step Files/FTS-104-01-L-DV.stp:
FILE_NAME( 'p:/temp/worker_127/temp/exporttempdir_3536_250_arHg7/format_0/FTS-104-01-L-DV.stp', '2021-02-04T22:43:18', ( 'License CC BY-ND 4.0' ), ( 'CADENAS' ), ' ', 'PARTsolutions', ' ' );
Step Files/SW - tact - SMT - HP0315AFKP2.stp:
FILE_NAME( 'p:/temp/worker_417/temp/exporttempdir_596_433_rRXF9/format_0/HP0315AFKP2.stp', '2021-01-26T08:17:15', ( 'License CC BY-ND 4.0' ), ( 'CADENAS' ), ' ', 'PARTsolutions', ' ' );
Step Files/SSQ-116-03-T-D.stp:
FILE_NAME( 'p:/temp/worker_283/temp/exporttempdir_4572_169_hQVpR/format_0/SSQ-116-03-T-D.stp', '2021-01-24T07:33:50', ( 'License CC BY-ND 4.0' ), ( 'CADENAS' ), ' ', 'PARTsolutions', ' ' );
Step Files/FFSD-04-S-01.00-01.stp:
FILE_NAME( 'p:/temp/worker_128/temp/exporttempdir_136_355_g8Icn/format_0/FFSD-04-S-01.00-01.stp', '2021-02-04T22:57:13', ( 'License CC BY-ND 4.0' ), ( 'CADENAS' ), ' ', 'PARTsolutions', ' ' );
Step Files/SSQ-118-03-T-D.stp:
FILE_NAME( 'e:/temp/worker_2/temp/exporttempdir_6680_208_ouniD/format_0/SSQ-118-03-T-D.stp', '2021-02-21T05:56:34', ( 'License CC BY-ND 4.0' ), ( 'CADENAS' ), ' ', 'PARTsolutions', ' ' );
Step Files/SSW-116-03-G-D.stp:
FILE_NAME( 'p:/temp/worker_332/temp/exporttempdir_3648_242_3xQBd/format_0/SSW-116-03-G-D.stp', '2021-01-24T07:26:37', ( 'License CC BY-ND 4.0' ), ( 'CADENAS' ), ' ', 'PARTsolutions', ' ' );
Step Files/USB4110-GF-A.stp:
FILE_NAME( 'p:/temp/worker_402/temp/exporttempdir_5088_68_9HKK9/format_0/USB4110-GF-A.stp', '2021-01-26T04:57:34', ( 'License CC BY-ND 4.0' ), ( 'CADENAS' ), ' ', 'PARTsolutions', ' ' );
